Ajsbreezy/EWB_Sensor_SP26/README.md

# EWB_Sensor_SP26
ESP32 controlled data collection in village of Malawi Africa.
