Ajsbreezy/EWB_Sensor_SP26/PCB/EWB_SENSOR_BOARD.kicad_pcb

## KiCad design PCB/EWB_SENSOR_BOARD.kicad_pcb (2026-04-07)

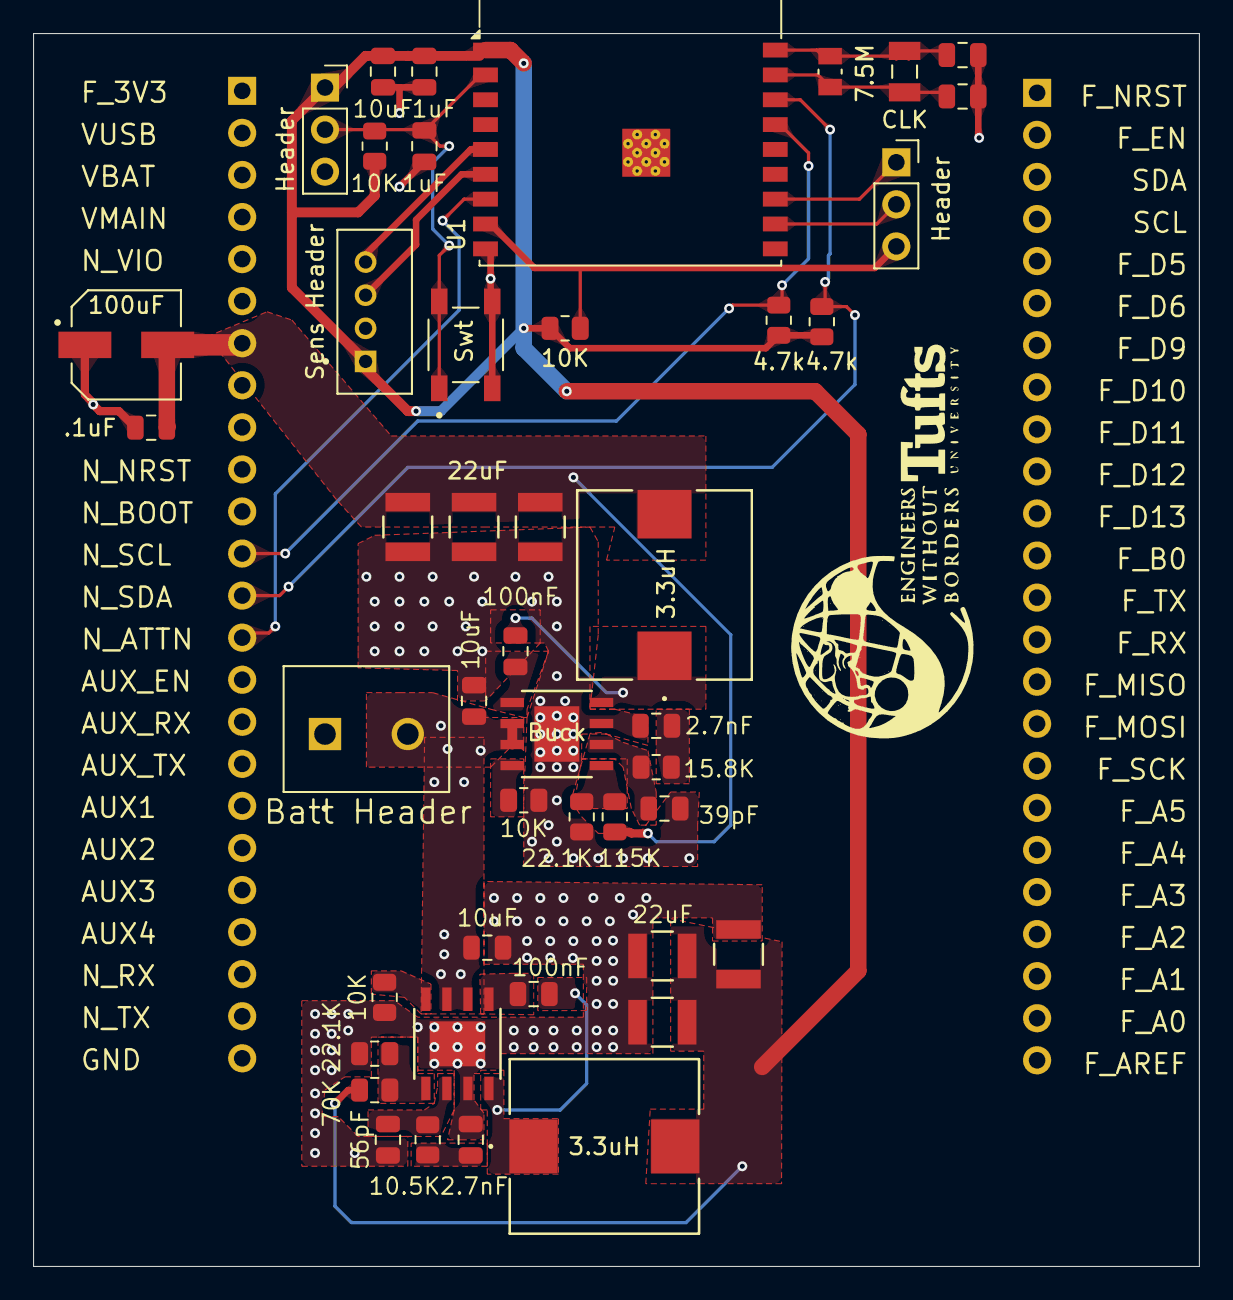
[picture p1: board EWB_SENSOR_BOARD.kicad_pcb from above]

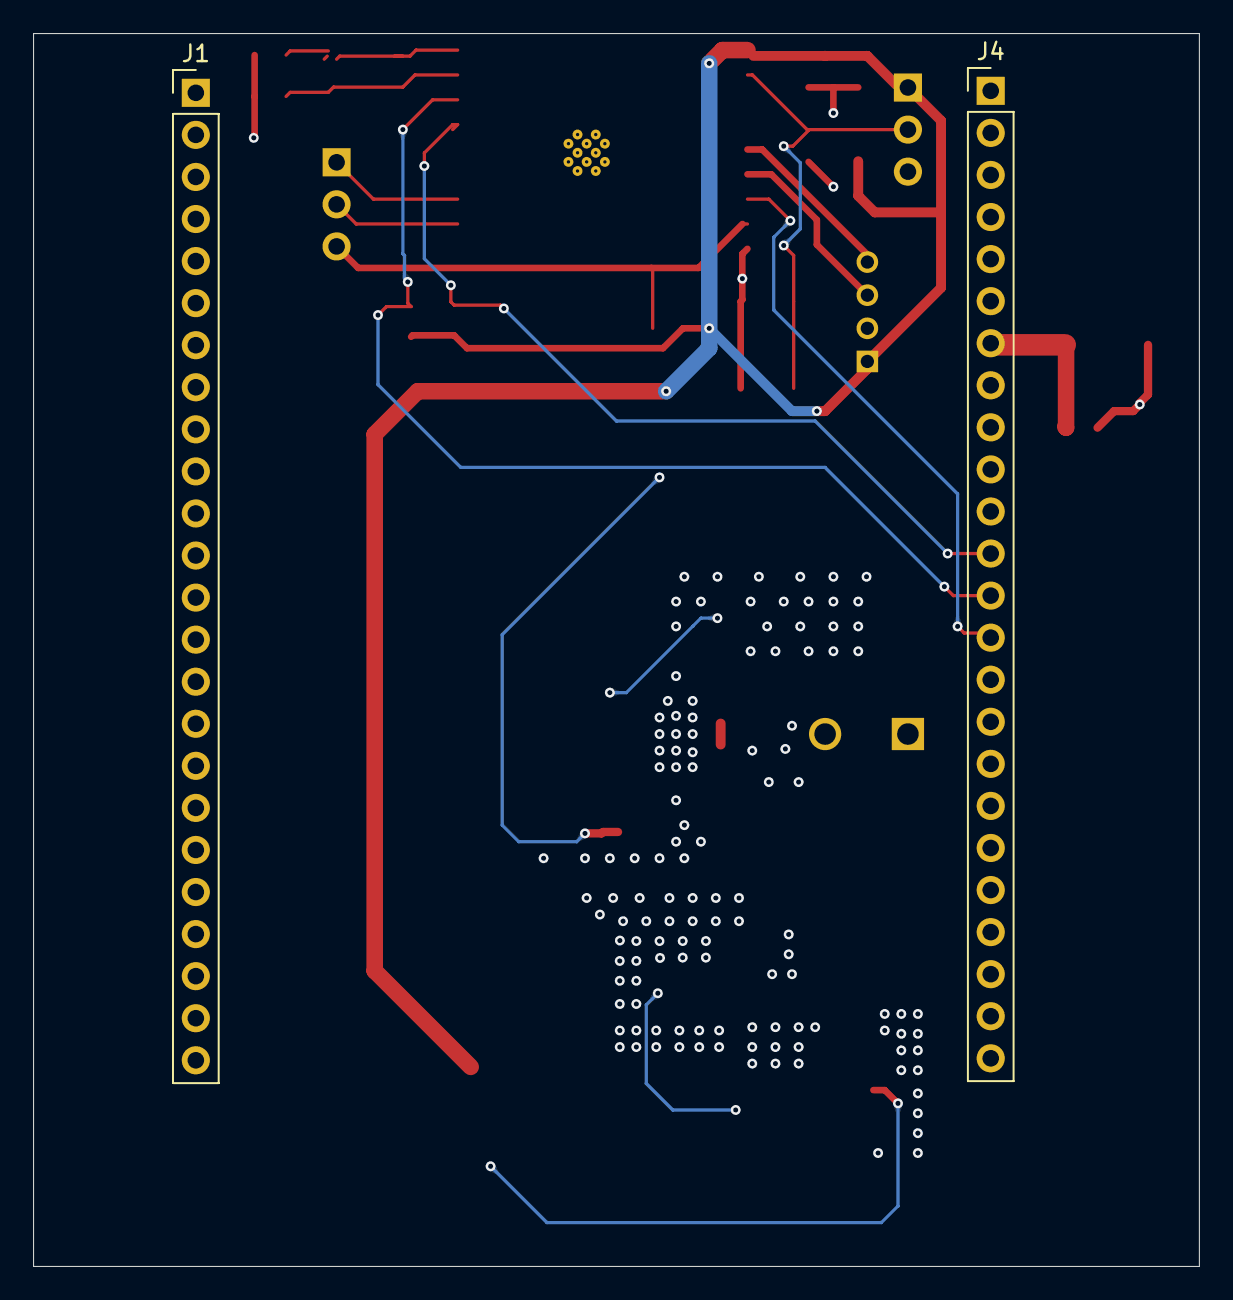
[picture p2: board EWB_SENSOR_BOARD.kicad_pcb from below]

Board: 4 copper layers, 70.4 x 74.5 mm, 47 parts (2 on the bottom side), 27 nets.

Parts:
1uF, 1uF#2: 1.0uF; C_0805_2012Metric
2.7nF, 2.7nF#2: 2.7nF; C_0805_2012Metric
3.3uH, 3.3uH#2: 3.3uH; IND_IHLP-4040DZ_VIS
4.7k, 4.7k#2: 4.7k; R_0805_2012Metric
7.5M: CR0805-JW-755ELF (7.5M); RESC2012X60N
10.5K: 10.5k; R_0805_2012Metric
10K, 10K#2, 10K#3, 10K#4: 10k; R_0805_2012Metric
10uF, 10uF#2, 10uF#3: 10.0uF; C_0805_2012Metric
15.8K: 15.8K; R_0805_2012Metric
22.1K, 22.1K#2: 22.1K; R_0805_2012Metric
22uF, 22uF#2: 22uF; CAP_CC1210_YAG
39pF: 39.0pF; C_0805_2012Metric
56pF: 56.0pF; C_0805_2012Metric
70K: 70k; R_0805_2012Metric
100nF, 100nF#2: 100.0nF; C_0805_2012Metric
100uF: 100uF; CAP_EEEFP1C101AP
115K: 115K; R_0805_2012Metric
.1uF: .1uF; C_0805_2012Metric
Batt Header: TB002-500-02BE; CUI_TB002-500-02BE
Buck: AP64500SP-13; SO-8EP_DIO
C6, C7: 15.0pF; C_0805_2012Metric
C13, C15, C19, C21: 22uF; CAP_CC1210_YAG
CLK: ABS07-32.768KHZ-T; XTAL_ABS07-32.768KHZ-T
Header: Conn_01x03_Pin; PinSocket_1x03_P2.54mm_Vertical
Header#2: Conn_01x03_Pin; PinSocket_1x03_P2.54mm_Vertical
J1, J4: Conn_01x24_Pin; PinHeader_1x24_P2.54mm_Vertical
Sens Header: B4B-PH-K-S; JST_B4B-PH-K-S
Swt: PTS_647_SM38_SMTR2_LFS; SW_PTS_647_SM38_SMTR2_LFS
U1: ESP32-C3-WROOM-02-N4; ESP32-C3-WROOM-02
U2: AP64500SP-13; SO-8EP_DIO

Connections:
+3.3V: 1uF.1, 3.3uH#2.2, 4.7k.1, 4.7k#2.1, 10K#2.2, 10K#4.1, 10uF#2.1, 22uF.2, 70K.2, C19.2, C21.2, Header#2.1, Sens Header.1, U1.1 (3V3)
+5V: 3.3uH.2, 22uF#2.2, 100uF.2, 115K.2, .1uF.2, C13.2, C15.2, J4.7
/12.8V: 10uF.2, 10uF#3.2, Batt Header.2, Buck.2 (VIN), Buck.3 (EN), U2.2 (VIN), U2.3 (EN)
/ESP_IO0: 10K#2.1, Header.3, U1.8 (IO9)
/ESP_RXD: Header.2, U1.11 (RXD)
/ESP_TXD: Header.1, U1.12 (TXD)
/FB: 22.1K.2, 115K.1, Buck.5 (FB)
/FB_1: 22.1K#2.2, 70K.1, U2.5 (FB)
/N_ATTN: J4.14, U1.7 (IO8)
/N_SCL: 4.7k#2.2, J4.12, U1.15 (IO3)
/N_SDA: 4.7k.2, J4.13, U1.16 (IO2)
/SNS_RX: Sens Header.4, U1.5 (IO6)
/SNS_TX: Sens Header.3, U1.6 (IO7)
/SW: 3.3uH.1, 100nF#2.2, Buck.8 (SW)
/SW_1: 3.3uH#2.1, 100nF.2, U2.8 (SW)
/XTAL_32K_N: 7.5M.2, C7.2, CLK.2, U1.17 (IO1)
/XTAL_32K_P: 7.5M.1, C6.2, CLK.1, U1.18 (IO0)
GND: 1uF.2, 1uF#2.1, 2.7nF.1, 2.7nF#2.1, 10K.1, 10K#3.1, 10uF.1, 10uF#2.2, 10uF#3.1, 22.1K.1, 22.1K#2.1, 22uF.1, 22uF#2.1, 39pF.1, 56pF.1, 100uF.1, .1uF.1, Batt Header.1, Buck.7 (GND), Buck.EPAD (GND), C6.1, C7.1, C13.1, C15.1, C19.1, C21.1, Header#2.3, J4.24, Sens Header.2, Swt.3, Swt.4, U1.9 (GND), U1.19 (GND__1), U2.7 (GND), U2.EPAD (GND)
unnamed: 2.7nF.2, 15.8K.1
unnamed: 2.7nF#2.2, 10.5K.1
unnamed: 100nF.1, U2.1 (BST)
unnamed: 10.5K.2, 56pF.2, U2.6 (COMP)
unnamed: 10K#3.2, U2.4 (RT/CLK)
unnamed: 100nF#2.1, Buck.1 (BST)
unnamed: 15.8K.2, 39pF.2, Buck.6 (COMP)
unnamed: 10K.2, Buck.4 (RT/CLK)
RESET: 1uF#2.2, 10K#4.2, Header#2.2, Swt.1, Swt.2, U1.2 (EN)
