Ajsbreezy/EWB_Sensor_SP26/(commit log)

2026-03-09 V1 of Schematic ready to route
2026-03-12 Added Notecarrier footprint
    [EWB_SENSOR_BOARD.kicad_pcb, EWB_SENSOR_BOARD.kicad_sch]
2026-03-23 Changed LDO to buck, found capacitors and inductors, added bulk capacitance
    [EWB_SENSOR_BOARD.kicad_pcb, EWB_SENSOR_BOARD.kicad_sch]
2026-03-24 distance sensor + last sem old code
2026-04-06 almost finished
    [EWB_SENSOR_BOARD.kicad_pcb, EWB_SENSOR_BOARD.kicad_sch]
2026-04-06 Finished PCB?
    [EWB_SENSOR_BOARD.kicad_pcb, EWB_SENSOR_BOARD.kicad_sch]
2026-04-07 questionable code that worked...
    we need to review how it fully works and implement the new sensor code in
2026-04-07 Final PCB
    [EWB_SENSOR_BOARD.kicad_pcb, EWB_SENSOR_BOARD.kicad_sch]
2026-04-07 Changed Silk Screen to include parts values
    [EWB_SENSOR_BOARD.kicad_pcb]
2026-04-14 combined comments, new sensor, rtc, no SD card
2026-05-02 Fixed and transitioned code to ESP-IDF Framework
    [main.c]
2026-05-02 fixed some platform.io linker issues
    [main.c]
